Maxunm/TShirtPress/README.md

# See [Rumel.IO](https://www.rumel.io/2019/11/05/T-Shirt-Press/)
