Maxunm/TShirtPress/Fusion 360 Files/Base Plate v3.stl

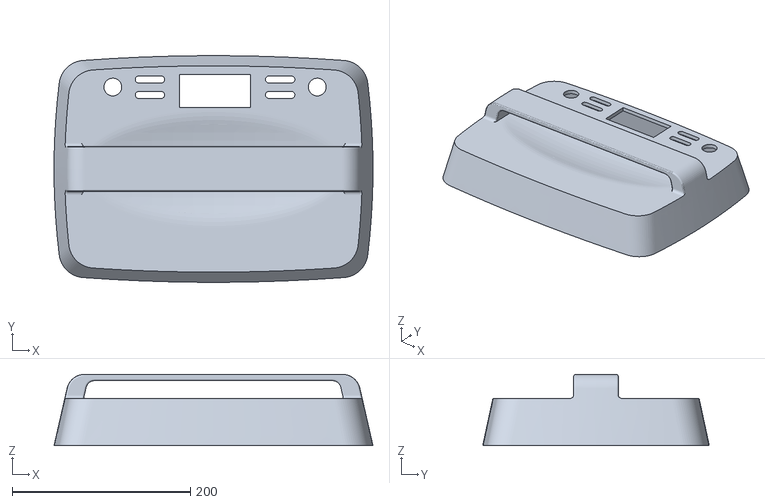
[picture p1: CAD file, 2020-02-03]
Fusion 360 Files/Base Plate v3.stl
358.1 x 254.3 x 80.0
