Maxunm/TShirtPress/(list of files, cad)

Other CAD files:
Fusion 360 Files/Base Plate v3.f3d
