Maxunm/TShirtPress/KiCad/T-ShirtPress/T-ShirtPress.kicad_pcb

## KiCad design KiCad/T-ShirtPress/T-ShirtPress.kicad_pcb (2020-07-02)

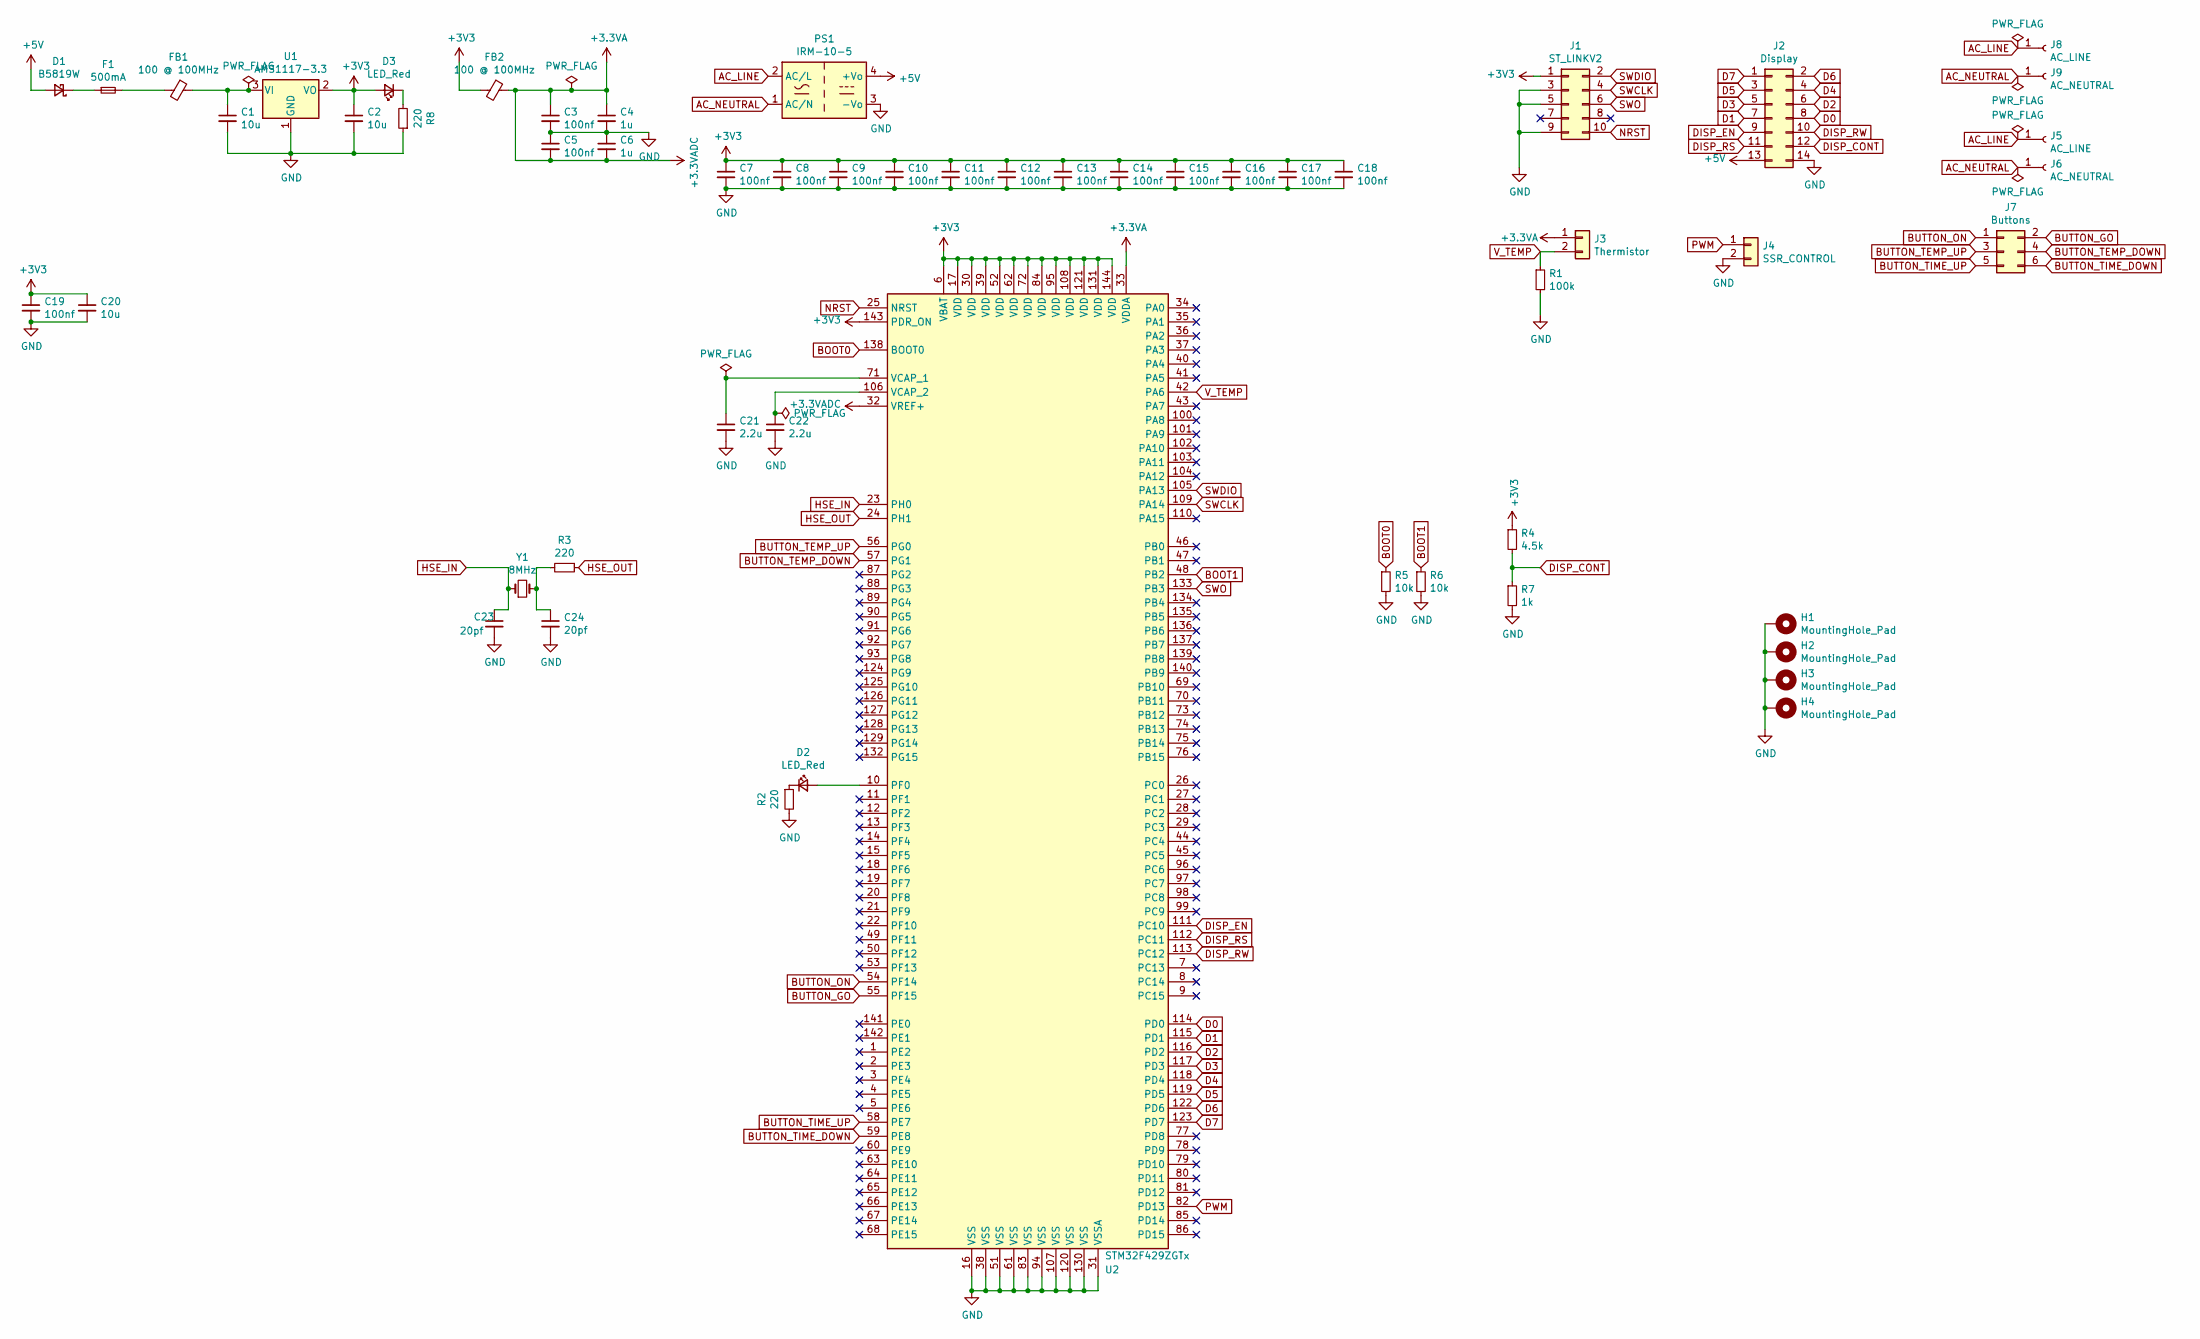
[picture p2: schematic T-ShirtPress.sch]

Parts:
C1, C2: 10u; C_0805_2012Metric
C3, C5, C7, C8, C9, C10, C11, C12, C13, C14, C15, C16, C17, C18, C19: 100nf; C_0402_1005Metric
C4, C6: 1u; C_0402_1005Metric
C20: 10u; C_0603_1608Metric
C21, C22: 2.2u; C_0603_1608Metric
C23, C24: 20pf; C_0402_1005Metric
D1: B5819W; D_SOD-123
D2, D3: LED_Red; LED_0603_1608Metric
F1: 500mA; Fuse_1206_3216Metric
FB1, FB2: 100 @ 100MHz; L_0805_2012Metric
H1, H2, H3, H4: MountingHole_Pad; MountingHole_4mm_Pad_Via
J1: ST_LINKV2; PinHeader_2x05_P1.27mm_Vertical_SMD
J2: Display; PinHeader_2x07_P2.54mm_Vertical
J3: Thermistor; JST_EH_B2B-EH-A_1x02_P2.50mm_Vertical
J4: SSR_CONTROL; JST_EH_B2B-EH-A_1x02_P2.50mm_Vertical
J5, J8: AC_LINE; SolderWire-2.5sqmm_1x01_D2.4mm_OD3.6mm
J6, J9: AC_NEUTRAL; SolderWire-2.5sqmm_1x01_D2.4mm_OD3.6mm
J7: Buttons; PinHeader_2x03_P2.54mm_Vertical
PS1: IRM-10-5; Converter_ACDC_MeanWell_IRM-10-xx_THT
R1: 100k; R_0805_2012Metric
R2, R3, R8: 220; R_0603_1608Metric
R4: 4.5k; R_Axial_DIN0204_L3.6mm_D1.6mm_P5.08mm_Horizontal
R5, R6: 10k; R_0402_1005Metric
R7: 1k; R_1206_3216Metric
U1: AMS1117-3.3; SOT-223-3_TabPin2
U2: STM32F429ZGTx; LQFP-144_20x20mm_P0.5mm
Y1: 8MHz; Crystal_SMD_5032-2Pin_5.0x3.2mm

Connections:
+3.3VA: C3.1, C4.1, C5.2, C6.2, FB2.1, J3.1, U2.32 (VREF+), U2.33 (VDDA)
+3V3: C2.1, C7.1, C8.1, C9.1, C10.1, C11.1, C12.1, C13.1, C14.1, C15.1, C16.1, C17.1, C18.1, C19.1, C20.1, D3.2 (A), FB2.2, J1.1, R4.1, U1.2 (VO), U2.6 (VBAT), U2.17 (VDD), U2.30 (VDD), U2.39 (VDD), U2.52 (VDD), U2.62 (VDD), U2.72 (VDD), U2.84 (VDD), U2.95 (VDD), U2.108 (VDD), U2.121 (VDD), U2.131 (VDD), U2.143 (PDR_ON), U2.144 (VDD); also elsewhere on the board
+5V: D1.2 (A), J2.13, PS1.4 (+Vo); also elsewhere on the board
AC_LINE: J5.1, J8.1, PS1.2 (AC/L); also elsewhere on the board
AC_NEUTRAL: J6.1, J9.1, PS1.1 (AC/N); also elsewhere on the board
BOOT0: R5.1, U2.138 (BOOT0)
BOOT1: R6.1, U2.48 (PB2)
BUTTON_GO: J7.2, U2.55 (PF15)
BUTTON_ON: J7.1, U2.54 (PF14)
BUTTON_TEMP_DOWN: J7.4, U2.57 (PG1)
BUTTON_TEMP_UP: J7.3, U2.56 (PG0)
BUTTON_TIME_DOWN: J7.6, U2.59 (PE8)
BUTTON_TIME_UP: J7.5, U2.58 (PE7)
D0: J2.8, U2.114 (PD0)
D1: J2.7, U2.115 (PD1)
D2: J2.6, U2.116 (PD2)
D3: J2.5, U2.117 (PD3)
D4: J2.4, U2.118 (PD4)
D5: J2.3, U2.119 (PD5)
D6: J2.2, U2.122 (PD6)
D7: J2.1, U2.123 (PD7)
DISP_CONT: J2.12, R4.2, R7.1
DISP_EN: J2.9, U2.111 (PC10)
DISP_RS: J2.11, U2.112 (PC11)
DISP_RW: J2.10, U2.113 (PC12)
GND: C1.2, C2.2, C3.2, C4.2, C5.1, C6.1, C7.2, C8.2, C9.2, C10.2, C11.2, C12.2, C13.2, C14.2, C15.2, C16.2, C17.2, C18.2, C19.2, C20.2, C21.2, C22.2, C23.2, C24.2, H1.1, H2.1, H3.1, H4.1, J1.3, J1.5, J1.9, J2.14, J4.2, PS1.3 (-Vo), R1.2, R2.2, R5.2, R6.2, R7.2, R8.1, U1.1 (GND), U2.16 (VSS), U2.31 (VSSA), U2.38 (VSS), U2.51 (VSS), U2.61 (VSS), U2.83 (VSS), U2.94 (VSS), U2.107 (VSS), U2.120 (VSS), U2.130 (VSS); also elsewhere on the board
HSE_IN: C23.1, U2.23 (PH0), Y1.1
HSE_OUT: R3.1, U2.24 (PH1)
NRST: J1.10, U2.25 (NRST)
unnamed: C1.1, FB1.1, U1.3 (VI)
unnamed: C21.1, U2.71 (VCAP_1)
unnamed: C22.1, U2.106 (VCAP_2)
unnamed: C24.1, R3.2, Y1.2
unnamed: D1.1 (K), F1.1
unnamed 34: D2.1 (K), R2.1; also elsewhere on the board
unnamed 35: D2.2 (A), U2.10 (PF0); also elsewhere on the board
unnamed 36: D3.1 (K), R8.2; also elsewhere on the board
unnamed: F1.2, FB1.2
PWM: J4.1, U2.82 (PD13)
SWCLK: J1.4, U2.109 (PA14)
SWDIO: J1.2, U2.105 (PA13)
SWO: J1.6, U2.133 (PB3)
V_TEMP: J3.2, R1.1, U2.42 (PA6)

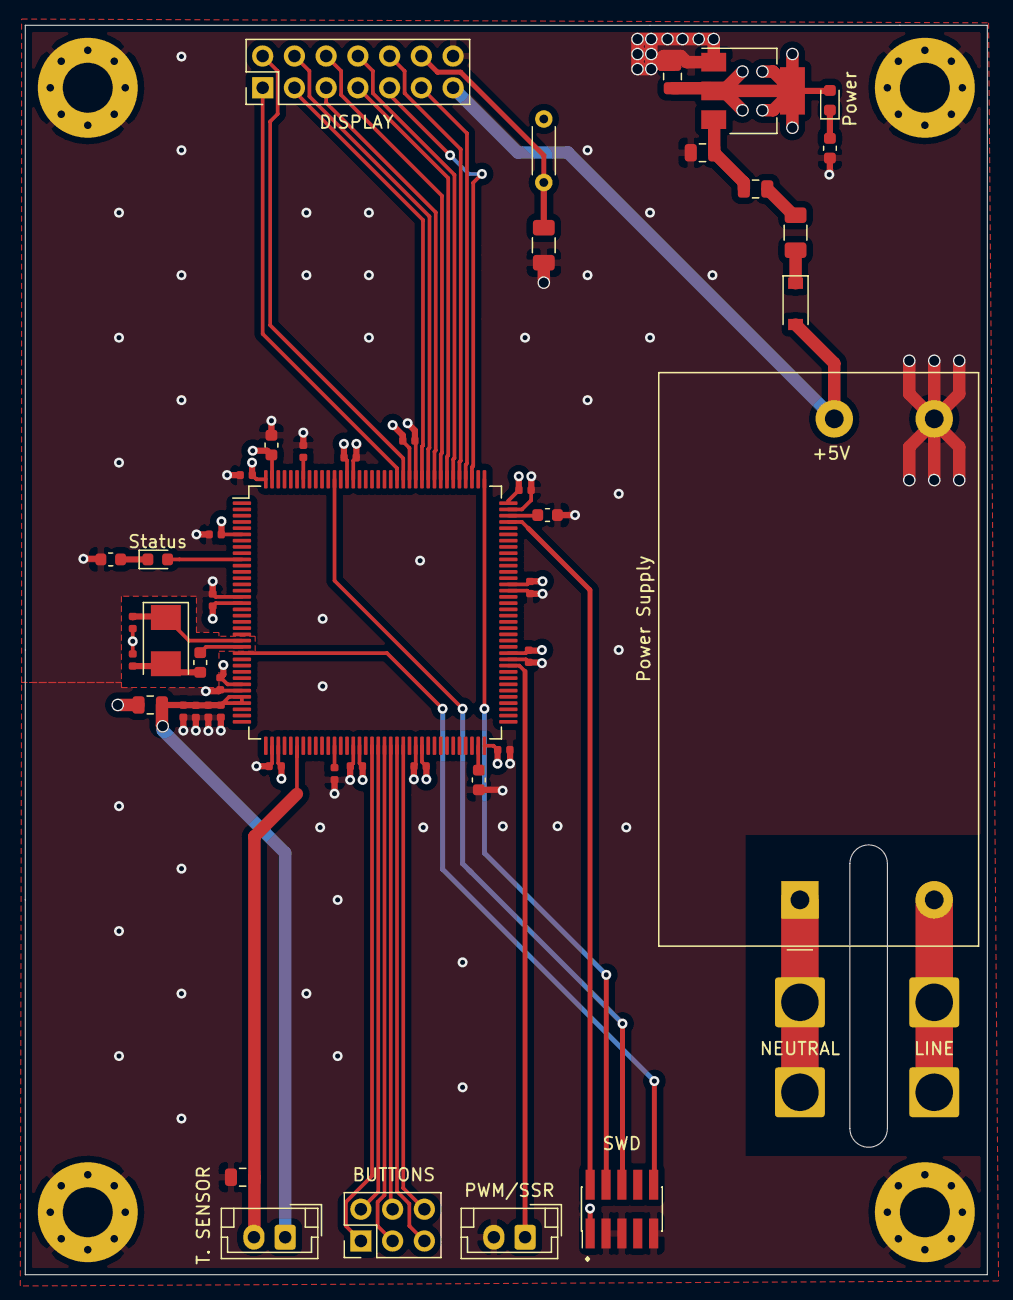
[picture p3: board T-ShirtPress.kicad_pcb from above]

Board: 4 copper layers, 77.0 x 100.0 mm, 55 parts (0 on the bottom side), 43 nets.

Other parts of the board:
LINE: AC_LINE; SolderWire-2.5sqmm_1x01_D2.4mm_OD3.6mm
NEUTRAL: AC_NEUTRAL; SolderWire-2.5sqmm_1x01_D2.4mm_OD3.6mm
Power: LED_Red; LED_0603_1608Metric
Power Supply: IRM-10-5; Converter_ACDC_MeanWell_IRM-10-xx_THT
Status: LED_Red; LED_0603_1608Metric

Their connections:
+3V3: Power.2; also elsewhere on the board
+5V: Power Supply.4; also elsewhere on the board
AC_LINE: LINE.1, Power Supply.2; also elsewhere on the board
AC_NEUTRAL: NEUTRAL.1, Power Supply.1; also elsewhere on the board
GND: Power Supply.3; also elsewhere on the board
unnamed 34: Status.1; also elsewhere on the board
unnamed 35: Status.2; also elsewhere on the board
unnamed 36: Power.1; also elsewhere on the board
