Maxunm/TShirtPress/Eagle Files/T-ShirtPress Schematic.sch

## EAGLE design Eagle Files/T-ShirtPress Schematic.sch (2020-02-04)

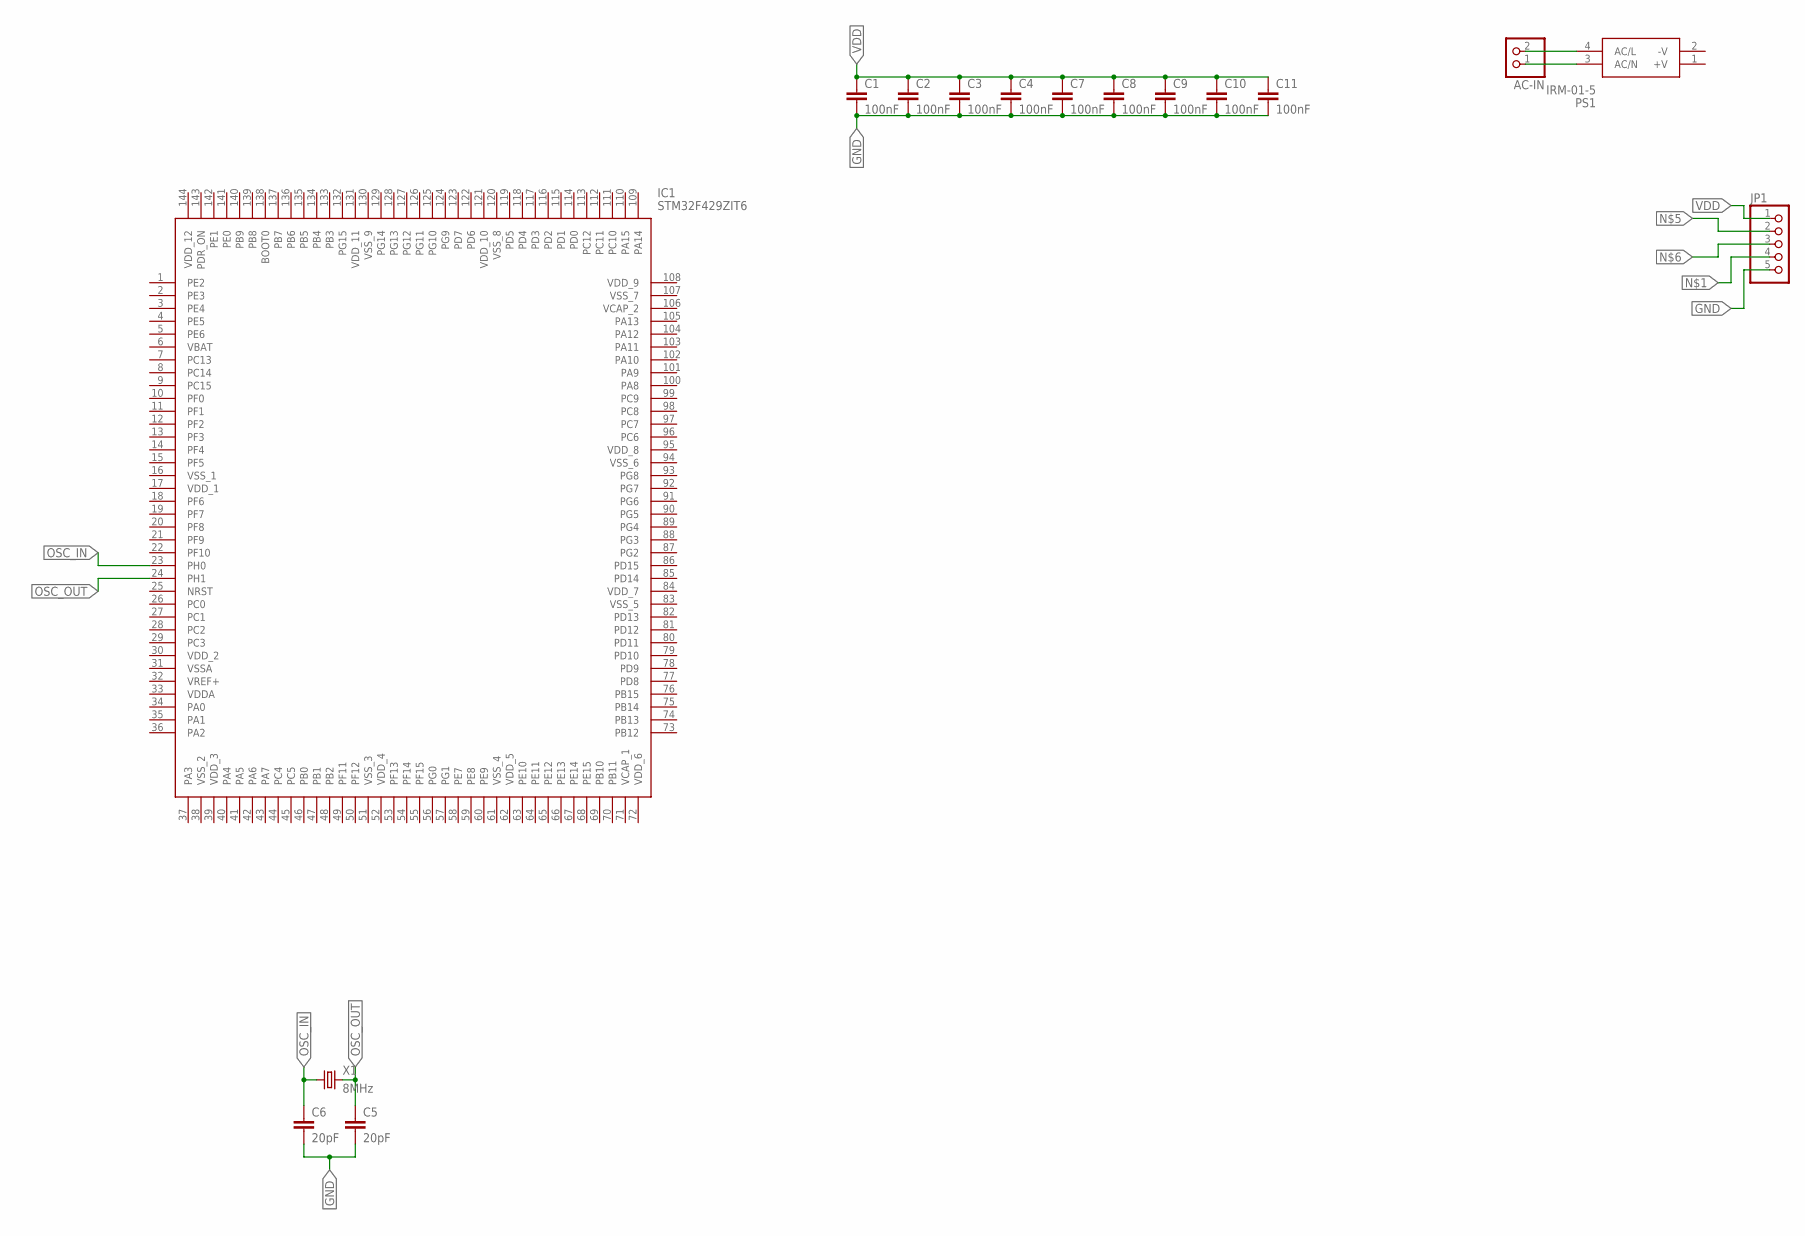
[picture p4: schematic T-ShirtPress Schematic.sch]

Parts:
AC-IN: PINHD-1X2; 1X02
C1, C2, C3, C4, C7, C8, C9, C10, C11: 100nF; C1206
C5, C6: 20pF; C1206
IC1: STM32F429ZIT6; QFP50P2200X2200X160-144N
JP1: PINHD-1X5; 1X05
PS1: IRM-01-5; IRM015
X1: 8MHz; HC49/S

Connections:
GND: C1.2, C2.2, C3.2, C4.2, C5.2, C6.2, C7.2, C8.2, C9.2, C10.2, C11.2, JP1.5
OSC_IN: C6.1, IC1.23 (PH0), X1.1
OSC_OUT: C5.1, IC1.24 (PH1), X1.2
VDD: C1.1, C2.1, C3.1, C4.1, C7.1, C8.1, C9.1, C10.1, C11.1, JP1.1
VLINE: AC-IN.2, PS1.4 (AC/L)
VNEUTRAL: AC-IN.1, PS1.3 (AC/N)
