Maxunm/TShirtPress/Src/main.c

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

/* Includes ------------------------------------------------------------------*/
#include "main.h"

/* USER CODE BEGIN Includes */
#include <math.h>
/* USER CODE END Includes */

ADC_HandleTypeDef hadc2;

TIM_HandleTypeDef htim4;

/* USER CODE BEGIN PV */
uint32_t tempValue = 0;
double tempK = 0;
double tempC = 0;
double tempF = 0;
double kp, ki, kd;
uint32_t currentTime, previousTime;
double elapsedTime;
double setPoint = 70;
double error, cumError, rateError, lastError;
unsigned char counter = 0;
unsigned int myPID = 0;
uint32_t finalAdc, beginAdc, adcTime;
/* USER CODE END PV */

void SystemClock_Config(void);
static void MX_GPIO_Init(void);
static void MX_ADC2_Init(void);
static void MX_TIM4_Init(void);
/* USER CODE BEGIN PFP */
int computePID(double inp);

/* USER CODE END PFP */

/**
  * @brief  The application entry point.
  * @retval int
  */
int main(void)
{
  /* MCU Configuration--------------------------------------------------------*/

  /* Reset of all peripherals, Initializes the Flash interface and the Systick. */
  HAL_Init();

  /* Configure the system clock */
  SystemClock_Config();

  /* Initialize all configured peripherals */
  MX_GPIO_Init();
  MX_ADC2_Init();
  MX_TIM4_Init();
  /* USER CODE BEGIN 2 */
  HAL_ADC_Start_IT(&hadc2);
  //Use PWM to control? or simple loop?
  kp = 19.56;
  ki = 0.71;
  kd = 134.26;
  TIM4->CCR2 = 300;
  HAL_TIM_PWM_Start(&htim4, TIM_CHANNEL_2);
  
  /* USER CODE END 2 */

  /* Infinite loop */
  /* USER CODE BEGIN WHILE */
  while (1)
  {
    if(counter==0){
      myPID = computePID(tempF);
      TIM4->CCR2 = (int)myPID;
      HAL_Delay(200);
      TIM4->CCR2 = 0;
      HAL_Delay(200);
    }
    /* USER CODE END WHILE */

    /* USER CODE BEGIN 3 */
  }
  /* USER CODE END 3 */
}

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
/* USER CODE BEGIN 4 */





void HAL_ADC_ConvCpltCallback(ADC_HandleTypeDef* hadc){
  tempValue = HAL_ADC_GetValue(&hadc2);

  tempK = 1.0/((1.0/298.15)+((1.0/4390.0)*(log(((4096.0/(double)tempValue)-1.0)))));//B value equation to calculate temprature of thermistor
  tempC = tempK - 273.15; //K to C
  tempF = ((9.0*tempC)/5.0)+32.0; //C to F
  tempF = tempF+20;

  
  HAL_ADC_Start_IT(&hadc2);

}

int computePID(double inp){
  currentTime = HAL_GetTick();                //get current time
  elapsedTime = (double)(currentTime - previousTime);        //compute time elapsed from previous computation
 
  error = setPoint - inp;                                // determine error
  cumError += error * elapsedTime;                // compute integral      
  rateError = (error - lastError)/elapsedTime;   // compute derivative
  double out;
  if(cumError < -0xFFFF){
    cumError = -0xFFFF;                                      //Clamping
  }
  if(cumError > 0xFFFF){
    cumError = 0xFFFF;                                       //Clamping
  }
    
  out = kp*error + ki*cumError + kd*rateError;
  
  if(out < 0){
    out = 0;
  }
  if(out > 0xFFFF){
    out = 0xFFFF;
  }
  lastError = error;                                //remember current error
  previousTime = currentTime;                        //remember current time
 
  return (int)out;
  

}










/* USER CODE END 4 */
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
