Maxunm/TShirtPress/Press.ioc

Mcu.UserName=STM32F429ZITx
PA13.Signal=SYS_JTMS-SWDIO
PA14.Signal=SYS_JTCK-SWCLK
PA6.Signal=ADCx_IN6
PB3.Signal=SYS_JTDO-SWO
PC10.GPIO_Label=en
PC10.Signal=GPIO_Output
PC11.GPIO_Label=rs
PC11.Signal=GPIO_Output
PC12.GPIO_Label=rw
PC12.Signal=GPIO_Output
PD0.Signal=GPIO_Output
PD1.Signal=GPIO_Output
PD13.Signal=S_TIM4_CH2
PD2.Signal=GPIO_Output
PD3.Signal=GPIO_Output
PD4.Signal=GPIO_Output
PD5.Signal=GPIO_Output
PD6.Signal=GPIO_Output
PD7.Signal=GPIO_Output
PE7.Signal=GPIO_Input
PE8.Signal=GPIO_Input
PF0.GPIO_Label=LED
PF0.Signal=GPIO_Output
PF14.Signal=GPIO_Input
PF15.Signal=GPIO_Input
PG0.Signal=GPIO_Input
PG1.Signal=GPIO_Input
PG13.Signal=GPIO_Output
PH0/OSC_IN.Signal=RCC_OSC_IN
PH1/OSC_OUT.Signal=RCC_OSC_OUT
