Maxunm/TShirtPress/(commit log)

2019-11-08 Wrote temp conversion code
    The temperature conversion code should take in the ADC value received by the microcontroller and convert it to all three usable temps.
2019-11-08 CubeMX broke things on my other computer
    [Press.ioc, main.c]
2019-11-12 Updated to include basic PID calculation
    Will need to further change to remove integral wind up and add a low pass filter to filter the noise for the derivative term.
    [Press.ioc, main.c]
2019-11-12 PID Implemented
    PID is now implemented and works as intended, the solid state relay needed a much slower carrier frequency for the PWM signal so the prescaller was set to 7. PID tuning is what needs to happen next.
2020-01-09 Actively working, needs a PID tune
2020-01-15 Added eagle files
    [T-ShirtPress Schematic.sch]
2020-01-16 Added parts to schematic
    Added STM32F429ZIT6 which I used for development and will be using for the bard that is created in this pcb. I most likely will be using the pcb assembly services of something like JLCPCB because I probably will be using parts that are too small to be hand soldered
2020-01-16 Updated schematic
    [T-ShirtPress Schematic.sch]
2020-02-03 Added Fusion files
    These files are the design for the "product" that is the T-Shirt Press
    [Base Plate v3.f3d, Base Plate v3.stl]
2020-02-03 More Schematic updates
    Just working on the schematic. Trying to double check all the power electronics. Will likely get design looked over by a peer after it is designed.
    [T-ShirtPress Schematic.sch]
2020-02-04 Enabled SWD and updated symbols on schematic
    [T-ShirtPress Schematic.sch]
2020-05-28 Rough placement on pcb & Migrate to KiCAD
    I've now roughly placed all the components on the pcb and will work on fine adjustment and routing in the next commit. I've also migrated to KiCAD, the workflow works slightly nicer for how I work because I can just draw the schematics before actually having to worry about footprints or picking the correct part.
    [T-ShirtPress.kicad_pcb, T-ShirtPress.sch]
2020-05-29 PCB Done!
    The pcb should be done now and it is ordered with assembly so hopefully everything goes well and it will arrive in roughly a week.
    [T-ShirtPress-BOM.csv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]
2020-06-03 Worked out BOMs
    I seperated the BOMs into three csvs now. One being the parts I ordered from Digikey, one for assebly from JLCPCB and one is just the raw output from KiCAD
    [T-ShirtPress-BOM-Digikey.csv, T-ShirtPress-BOM-JLCPCB.csv, T-ShirtPress-BOM-KiCAD.csv]
2020-07-02 Fixed error with PCB layout
    [T-ShirtPress.kicad_pcb]
