Maxunm/TShirtPress/(notices)

Notices in the files:
Src/main.c:
COPYRIGHT(c) 2019 STMicroelectronics
(C) COPYRIGHT STMicroelectronics *****END OF FILE
